freetronics/LEOPADMINI/LEOPADMINI.brd

## EAGLE design LEOPADMINI.brd (2020-03-17)

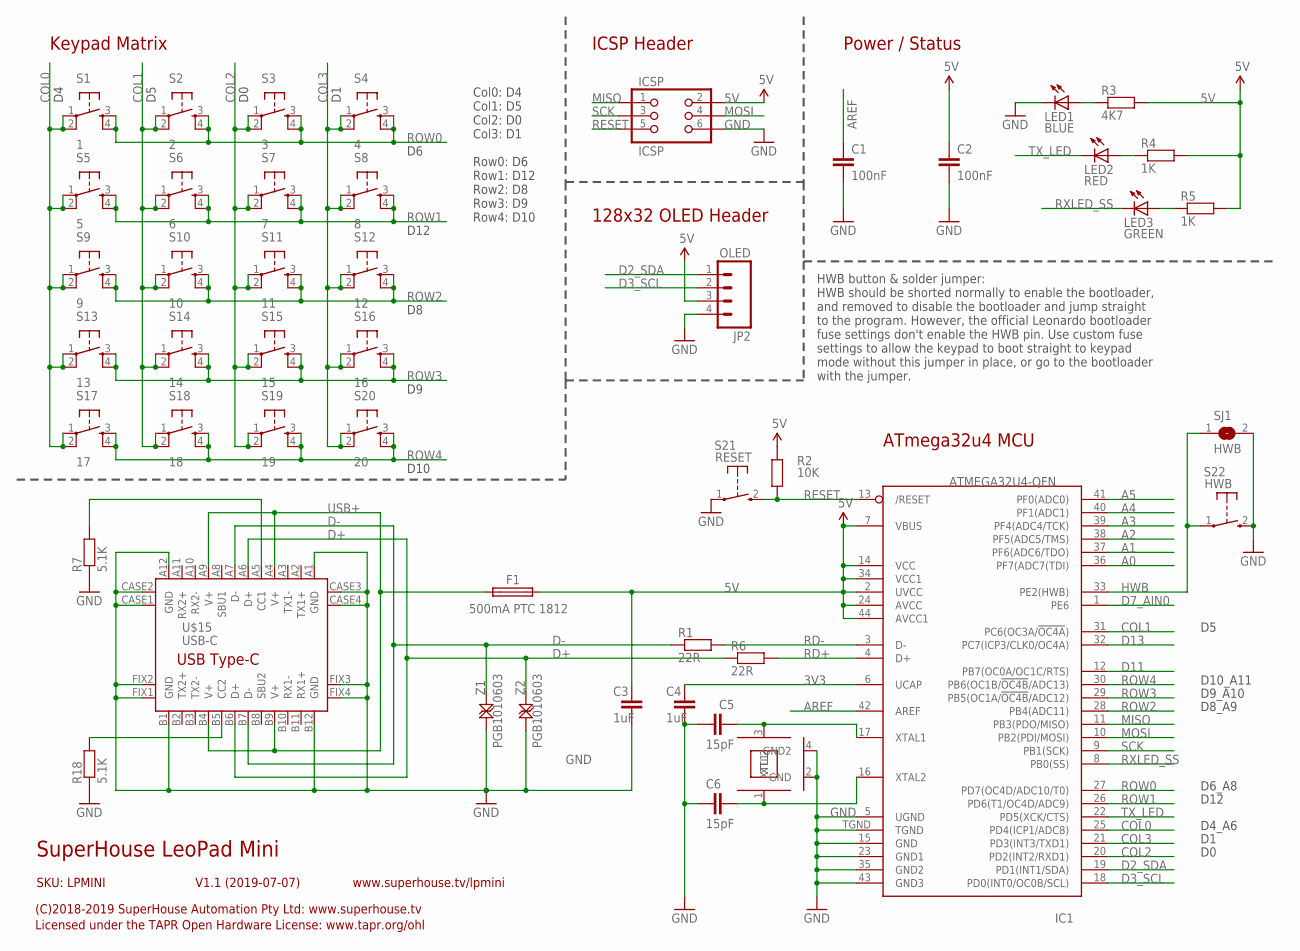
[picture p1: schematic LEOPADMINI.sch]

Parts:
C1, C2: 100nF; C0603
C3, C4: 1uF; C0603
C5, C6: 15pF; C0603
F1: 500mA PTC 1812; 1812
IC1: ATMEGA32U4-QFN; QFN-44N
ICSP: ICSP; 2X03PTH
JP2: OLED; 1X04
LED1: BLUE; LED-0603
LED2: RED; LED-0603
LED3: GREEN; LED-0603
R1, R6: 22R; R0603
R2: 10K; R0603
R3: 4K7; R0603
R4, R5: 1K; R0603
R7, R18: 5.1K; R0603
S1: 1; TACTILE-PTH-6MM
S2: 2; TACTILE-PTH-6MM
S3: 3; TACTILE-PTH-6MM
S4: 4; TACTILE-PTH-6MM
S5: 5; TACTILE-PTH-6MM
S6: 6; TACTILE-PTH-6MM
S7: 7; TACTILE-PTH-6MM
S8: 8; TACTILE-PTH-6MM
S9: 9; TACTILE-PTH-6MM
S10: 10; TACTILE-PTH-6MM
S11: 11; TACTILE-PTH-6MM
S12: 12; TACTILE-PTH-6MM
S13: 13; TACTILE-PTH-6MM
S14: 14; TACTILE-PTH-6MM
S15: 15; TACTILE-PTH-6MM
S16: 16; TACTILE-PTH-6MM
S17: 17; TACTILE-PTH-6MM
S18: 18; TACTILE-PTH-6MM
S19: 19; TACTILE-PTH-6MM
S20: 20; TACTILE-PTH-6MM
S21: RESET; TACTILE_SMD_3X4X2
S22: HWB; TACTILE_SMD_3X4X2
SJ1: HWB; SJ
U$15: USB-C; USB-C-U52A
XTL1: 16MHz; CRYSTAL-SMD-3X2
Z1, Z2: PGB1010603; TVS0603

Connections:
3V3: C4.2, IC1.6 (UCAP)
5V: C2.1, C3.1, F1.2, IC1.2 (UVCC), IC1.7 (VBUS), IC1.14 (VCC), IC1.24 (AVCC), IC1.34 (VCC1), IC1.44 (AVCC1), ICSP.2, JP2.3, R2.2, R3.2, R4.2, R5.2
A0: IC1.36 (PF7(ADC7(TDI))
A1: IC1.37 (PF6(ADC6/TDO))
A2: IC1.38 (PF5(ADC5/TMS))
A3: IC1.39 (PF4(ADC4/TCK))
A4: IC1.40 (PF1(ADC1))
A5: IC1.41 (PF0(ADC0))
AREF: C1.1, IC1.42 (AREF)
COL0: IC1.25 (PD4(ICP1/ADC8)), S1.1, S1.2, S5.1, S5.2, S9.1, S9.2, S13.1, S13.2, S17.1, S17.2
COL1: IC1.31 (PC6(OC3A/!OC4A!)), S2.1, S2.2, S6.1, S6.2, S10.1, S10.2, S14.1, S14.2, S18.1, S18.2
COL2: IC1.20 (PD2(INT2/RXD1)), S3.1, S3.2, S7.1, S7.2, S11.1, S11.2, S15.1, S15.2, S19.1, S19.2
COL3: IC1.21 (PD3(INT3/TXD1)), S4.1, S4.2, S8.1, S8.2, S12.1, S12.2, S16.1, S16.2, S20.1, S20.2
D2_SDA: IC1.19 (PD1(INT1/SDA)), JP2.1
D3_SCL: IC1.18 (PD0(INT0/OC0B/SCL)), JP2.2
D7_AIN0: IC1.1 (PE6)
D11: IC1.12 (PB7(OC0A/OC1C/RTS))
D13: IC1.32 (PC7(ICP3/CLK0/OC4A))
D+: R6.1, U$15.A6 (D+), U$15.B6 (D+), Z2.2
D-: R1.1, U$15.A7 (D-), U$15.B7 (D-), Z1.2
GND: C1.2, C2.2, C3.2, C4.1, C5.1, C6.1, IC1.5 (UGND), IC1.15 (GND), IC1.23 (GND1), IC1.35 (GND2), IC1.43 (GND3), IC1.TGND, ICSP.6, JP2.4, LED1.C, R7.1, R18.1, S21.1, S22.2 (S), SJ1.2, U$15.A1 (GND), U$15.A12 (GND), U$15.B1 (GND), U$15.B12 (GND), U$15.CASE1 (GND), U$15.CASE2 (GND), U$15.CASE3 (GND), U$15.CASE4 (GND), U$15.FIX1 (GND), U$15.FIX2 (GND), U$15.FIX3 (GND), U$15.FIX4 (GND), XTL1.2 (GND), XTL1.4 (GND2), Z1.1, Z2.1
HWB: IC1.33 (PE2(HWB)), S22.1, SJ1.1
MISO: IC1.11 (PB3(PDO/MISO)), ICSP.1
MOSI: IC1.10 (PB2(PDI/MOSI)), ICSP.4
unnamed: R18.2, U$15.B5 (CC2)
unnamed: LED1.A, R3.1
unnamed: LED2.A, R4.1
unnamed: LED3.A, R5.1
unnamed: C5.2, IC1.17 (XTAL1), XTL1.3 (XTL2)
unnamed: C6.2, IC1.16 (XTAL2), XTL1.1 (XTL1)
unnamed: R7.2, U$15.A5 (CC1)
RD+: IC1.4 (D+), R6.2
RD-: IC1.3 (D-), R1.2
RESET: IC1.13 (/RESET), ICSP.5, R2.1, S21.2 (S)
ROW0: IC1.27 (PD7(OC4D/ADC10/T0)), S1.3, S1.4, S2.3, S2.4, S3.3, S3.4, S4.3, S4.4
ROW1: IC1.26 (PD6(T1/OC4D/ADC9)), S5.3, S5.4, S6.3, S6.4, S7.3, S7.4, S8.3, S8.4
ROW2: IC1.28 (PB4(ADC11)), S9.3, S9.4, S10.3, S10.4, S11.3, S11.4, S12.3, S12.4
ROW3: IC1.29 (PB5(OC1A/!OC4B!/ADC12)), S13.3, S13.4, S14.3, S14.4, S15.3, S15.4, S16.3, S16.4
ROW4: IC1.30 (PB6(OC1B/!OC4B!/ADC13)), S17.3, S17.4, S18.3, S18.4, S19.3, S19.4, S20.3, S20.4
RXLED_SS: IC1.8 (PB0(SS)), LED3.C
SCK: IC1.9 (PB1(SCK)), ICSP.3
TX_LED: IC1.22 (PD5(XCK/CTS)), LED2.C
USB+: F1.1, U$15.A4 (V+), U$15.A9 (V+), U$15.B4 (V+), U$15.B9 (V+)

Notes on the sheet:
ICSP Header
ATmega32u4 MCU
HWB button & solder jumper: HWB should be shorted normally to enable the bootloader, and removed to disable the bootloader and jump straight to the program. However, the official Leonardo bootloader fuse settings don't enable the HWB pin. Use custom fuse settings to allow the keypad to boot straigh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
SuperHouse LeoPad Mini
V1.1 (2019-07-07)
SKU: LPMINI
(C)2018-2019 SuperHouse Automation Pty Ltd: www.superhouse.tv
Licensed under the TAPR Open Hardware License: www.tapr.org/ohl
www.superhouse.tv/lpmini
Power / Status
D10_A11
D9_A10
D8_A9
D6_A8
D12
Col0: D4 Col1: D5 Col2: D0 Col3: D1 Row0: D6 Row1: D12 Row2: D8 Row3: D9 Row4: D10
Keypad Matrix
D4_A6
128x32 OLED Header
D10

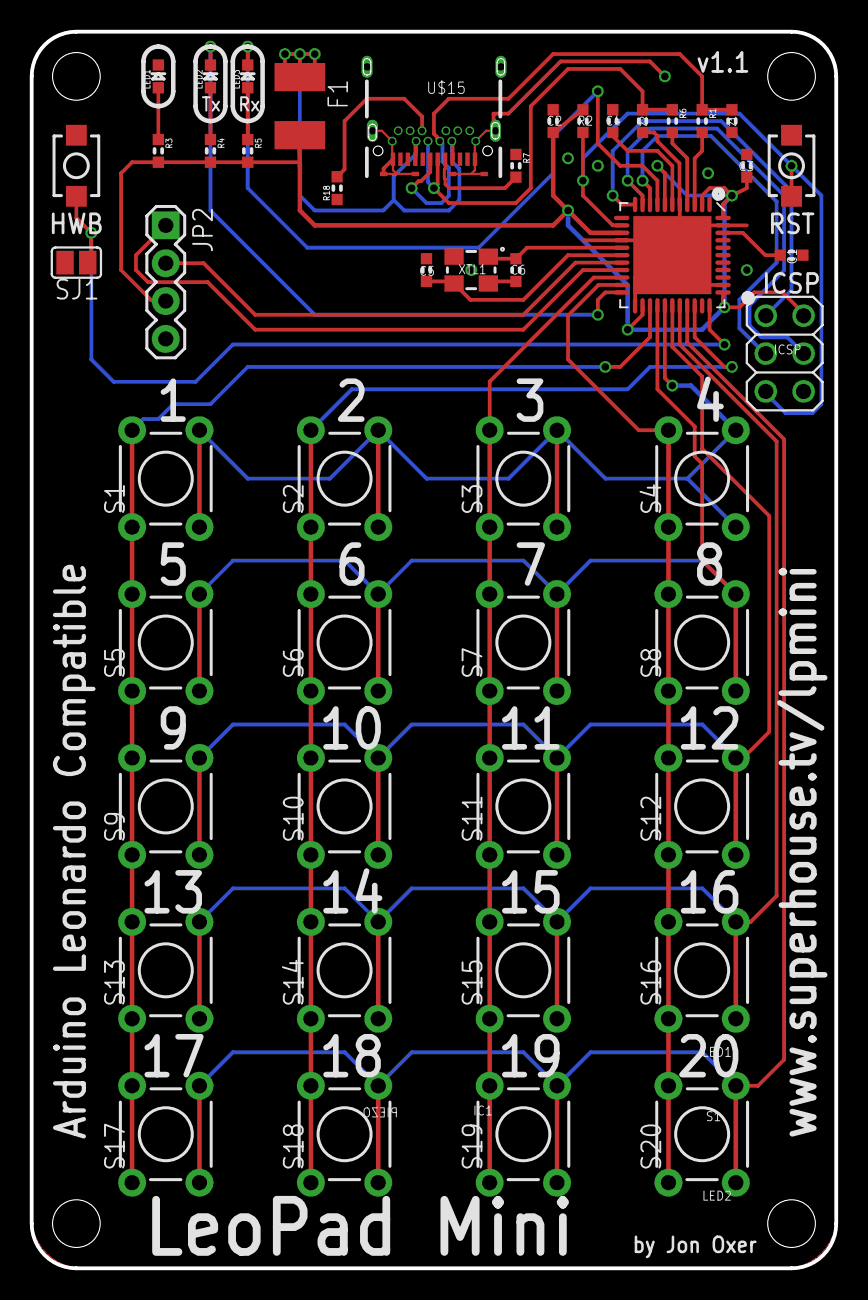
[picture p2: board LEOPADMINI.brd from above]

Board: 2 copper layers, 54.0 x 83.0 mm, 48 parts (0 on the bottom side), 34 nets.
