freetronics/LEOPADMINI/(commit log)

2019-06-01 Fixed button spacing for v1.0 release
    [LEOPADMINI.brd]
2019-06-12 Improved designator positions
    [LEOPADMINI.brd, LEOPADMINI.sch]
2019-07-01 Replaced most parts using SuperHouse library to add 3D models
    [LEOPADMINI.brd, LEOPADMINI.sch]
2019-07-07 Replaced parts using SuperHouse library to add 3D models
    [LEOPADMINI.brd, LEOPADMINI.sch]
2020-03-17 Regenerated Fusion360 export
    [LEOPADMINI.brd]
