freetronics/LEOPADMINI/(notices)

Notices in the files:
LEOPADMINI.brd:
Copyright 2018 SuperHouse Automation Pty Ltd
Released under the TAPR Open Hardware License
